EthicalEarth/Radio_SI4735_v1.0_stable/README.md

# Radio_SI4735_v1.0_stable
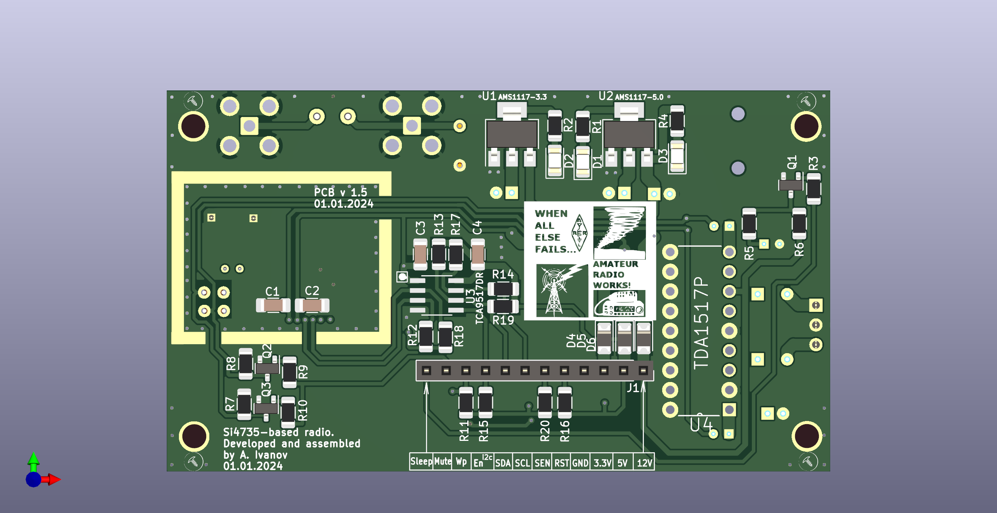
[picture p1: Gerber/SI4735t.png]
Top view

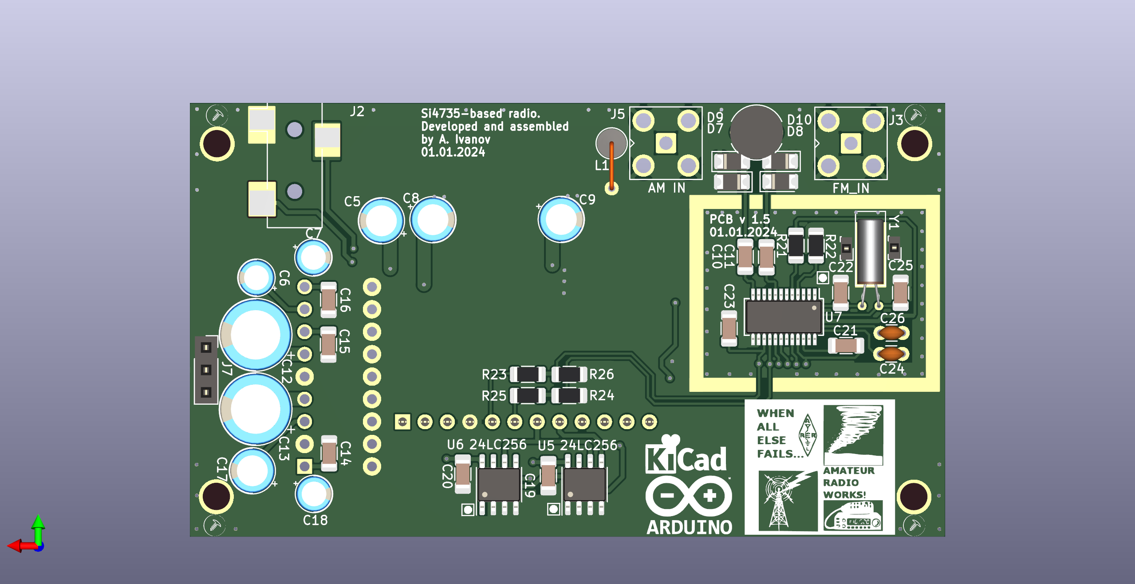
[picture p2: Gerber/SI4735b.png]
Bottom view
