EthicalEarth/Radio_SI4735_v1.0_stable/TCA9517DR/TCA9517DR.step

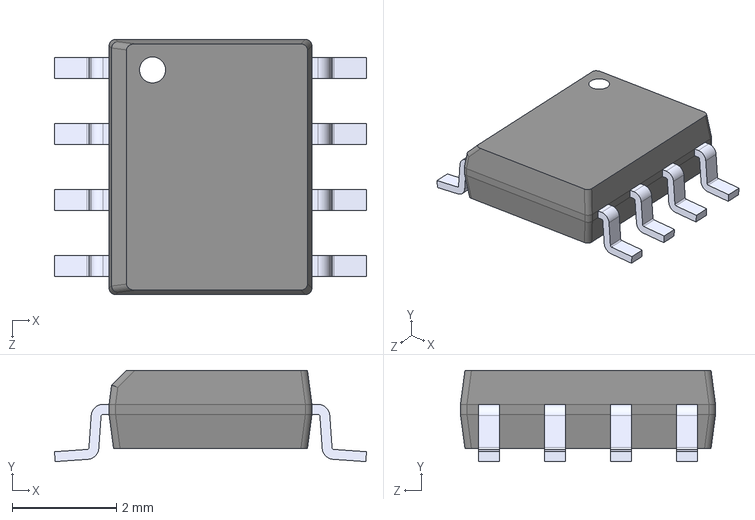
[picture p3: CAD file, 2024-03-23]
TCA9517DR/TCA9517DR.step
5.99 x 1.75 x 4.90 mm
