EthicalEarth/Radio_SI4735_v1.0_stable/TDA1517/TDA1517P_N3_112.step

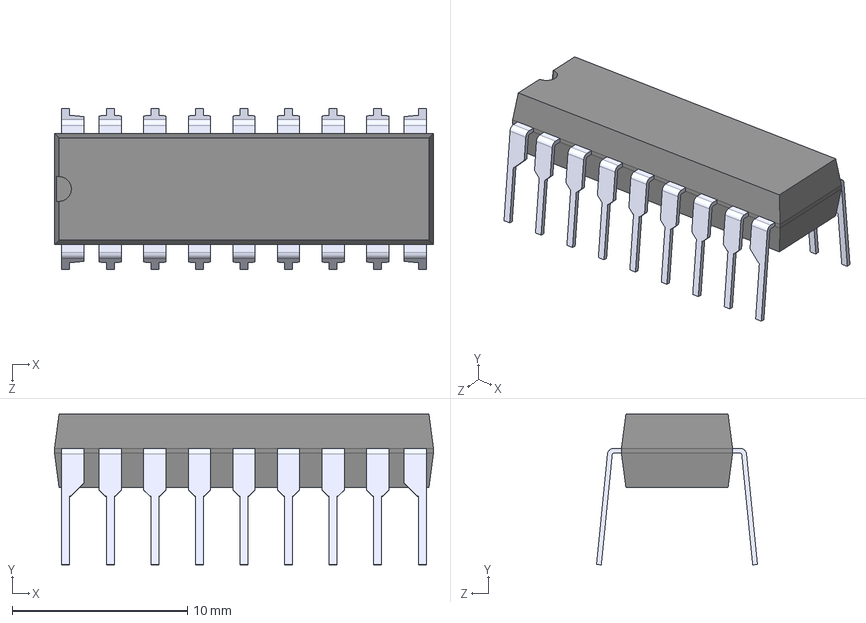
[picture p4: CAD file, 2024-03-23]
TDA1517/TDA1517P_N3_112.step
21.6 x 8.60 x 9.17 mm
