EthicalEarth/Radio_SI4735_v1.0_stable/SI4735.kicad_pcb

## KiCad design SI4735.kicad_pcb (2024-03-27)

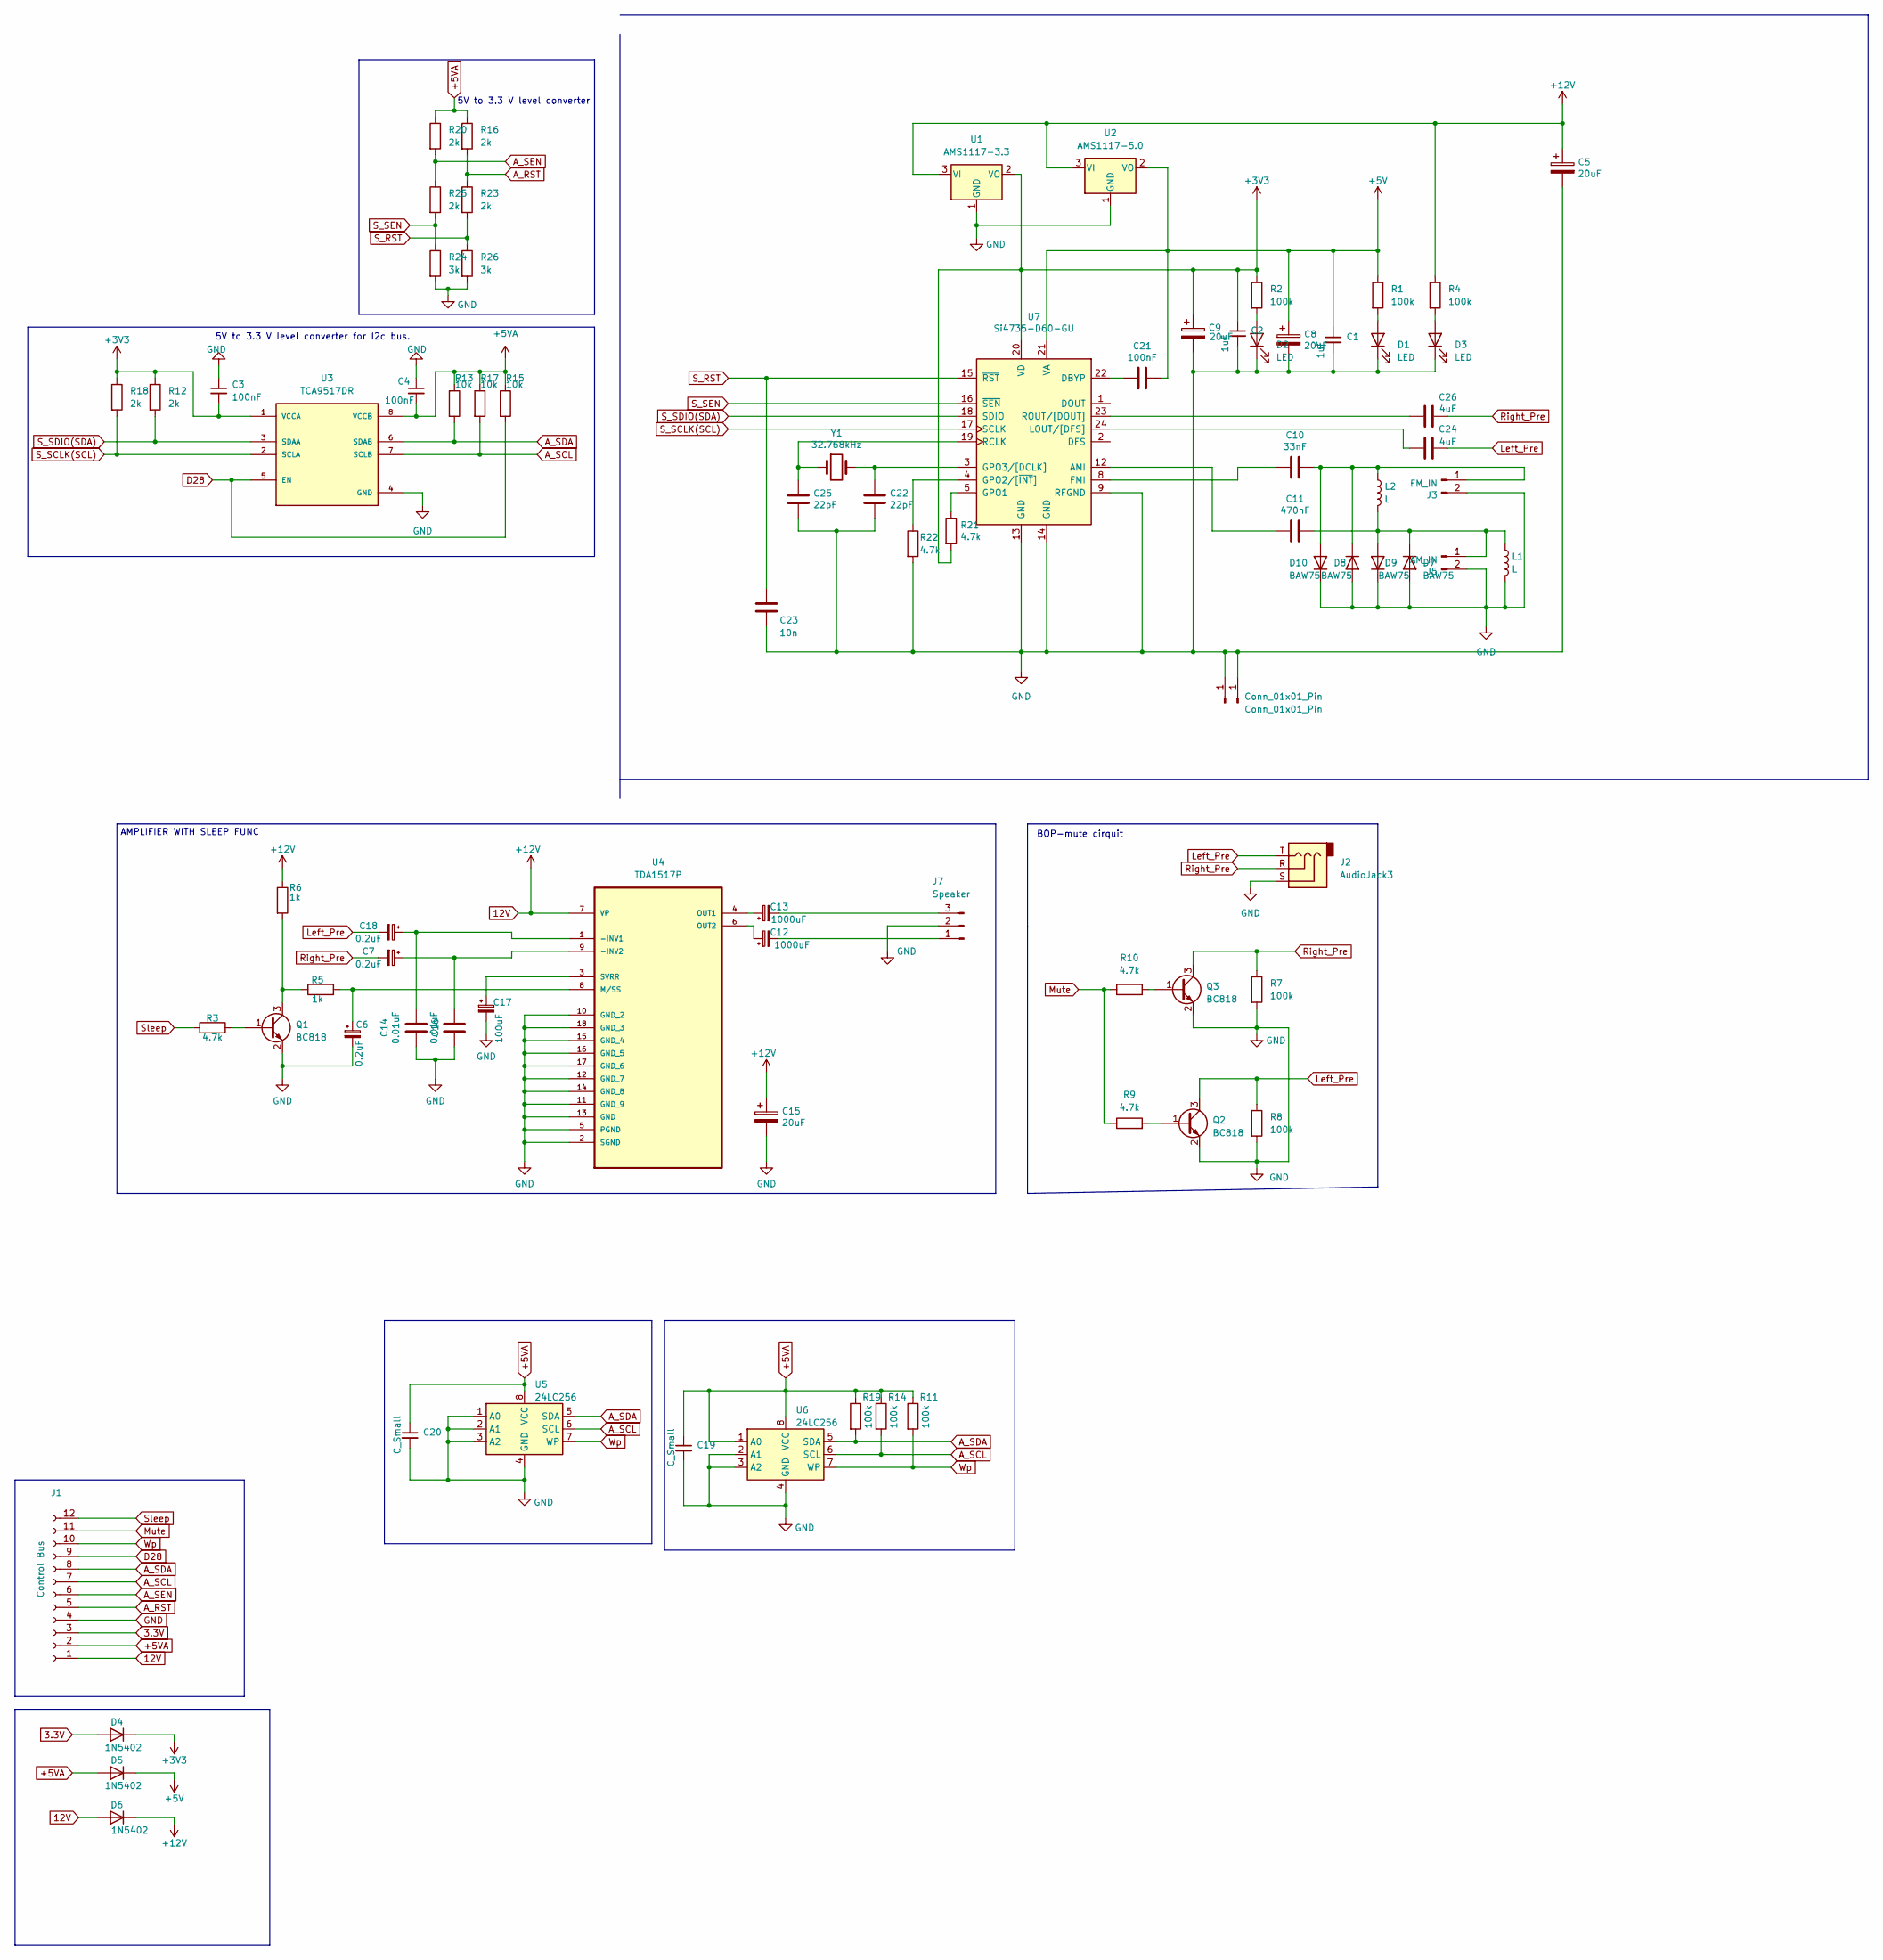
[picture p5: schematic SI4735.kicad_sch]

Parts:
C1, C2: 1uF; C_1206_3216Metric_Pad1.33x1.80mm_HandSolder
C3, C4, C21: 100nF; C_1206_3216Metric
C5, C8, C9: 20uF; CP_Radial_D5.0mm_P2.00mm
C6, C7, C18: 0.2uF; CP_Radial_D4.0mm_P2.00mm
C10: 33nF; C_1206_3216Metric
C11: 470nF; C_1206_3216Metric
C12, C13: 1000uF; CP_Radial_D8.0mm_P3.80mm
C14, C16: 0.01uF; C_1206_3216Metric
C15: 20uF; C_1206_3216Metric
C17: 100uF; CP_Radial_D5.0mm_P2.00mm
C19, C20: C_Small; C_1206_3216Metric_Pad1.33x1.80mm_HandSolder
C22, C25: 22pF; C_1206_3216Metric
C23: 10n; C_1206_3216Metric
C24, C26: 4uF; C_Disc_D3.0mm_W1.6mm_P2.50mm
D1, D2, D3: LED; LED_1206_3216Metric
D4, D5, D6: 1N5402; D_1206_3216Metric
D7, D8, D9, D10: BAW75; D_1206_3216Metric
J1: Control Bus; PinSocket_1x12_P2.54mm_Vertical
J2: AudioJack3; Jack_3.5mm_CUI_SJ-3523-SMT_Horizontal
J3: FM_IN; SMA_Amphenol_901-143_Horizontal
J4, J6: Conn_01x01_Pin; PinSocket_1x01_P1.27mm_Vertical
J5: AM_IN; SMA_Amphenol_901-143_Horizontal
J7: Speaker; PinSocket_1x03_P2.54mm_Vertical
L1: L; L_Axial_L7.0mm_D3.3mm_P5.08mm_Vertical_Fastron_MICC
L2: L; L_Radial_D6.0mm_P4.00mm
Q1, Q2, Q3: BC818; SOT-23
R1, R2, R4, R7, R8, R11, R14, R19: 100k; R_1206_3216Metric
R3, R9, R10, R21, R22: 4.7k; R_1206_3216Metric
R5, R6: 1k; R_1206_3216Metric
R12, R16, R18, R20, R23, R25: 2k; R_1206_3216Metric
R13, R15, R17: 10k; R_1206_3216Metric
R24, R26: 3k; R_1206_3216Metric
U1: AMS1117-3.3; SOT-223-3_TabPin2
U2: AMS1117-5.0; SOT-223-3_TabPin2
U3: TCA9517DR; SOIC127P599X175-8N; PARTREV D
U4: TDA1517P; DIP254P762X470-18; MPN TDA1517P/N3,112
U5, U6: 24LC256; SOIC-8_3.9x4.9mm_P1.27mm
U7: Si4735-D60-GU; SSOP-24_3.9x8.7mm_P0.635mm
Y1: 32.768kHz; Crystal_C38-LF_D3.0mm_L8.0mm_Horizontal

Connections:
3.3V: D4.2 (A), J1.3
12V: C5.1, C15.1, D6.1 (K), D6.2 (A), J1.1, R4.1, R6.1, U1.3 (VI), U2.3 (VI), U4.7 (VP)
+3V3: C2.1, C3.2, C9.1, D4.1 (K), R2.1, R12.1, R18.1, R21.2, U1.2 (VO), U3.1 (VCCA), U7.20 (VD)
+5V: C1.1, C8.1, C21.1, D5.1 (K), R1.1, U2.2 (VO), U7.21 (VA)
+5VA: C4.2, C19.1, C20.1, D5.2 (A), J1.2, R11.1, R13.1, R14.1, R15.1, R16.1, R17.1, R19.1, R20.1, U3.8 (VCCB), U5.8 (VCC), U6.1 (A0), U6.8 (VCC)
A_RST: J1.5, R16.2, R23.1
A_SCL: J1.7, R14.2, R17.2, U3.7 (SCLB), U5.6 (SCL), U6.6 (SCL)
A_SDA: J1.8, R13.2, R19.2, U3.6 (SDAB), U5.5 (SDA), U6.5 (SDA)
A_SEN: J1.6, R20.2, R25.1
D28: J1.9, R15.2, U3.5 (EN)
GND: C1.2, C2.2, C3.1, C4.1, C5.2, C6.2, C8.2, C9.2, C14.2, C15.2, C16.2, C17.2, C19.2, C20.2, C22.2, C23.2, C25.2, D1.1 (K), D2.1 (K), D3.1 (K), D7.2 (A), D8.2 (A), D9.1 (K), D10.1 (K), J1.4, J2.S, J3.2, J4.1, J5.2, J6.1, J7.2, L1.2, Q1.2 (E), Q2.2 (E), Q3.2 (E), R7.2, R8.2, R22.2, R24.2, R26.2, U1.1 (GND), U2.1 (GND), U3.4 (GND), U4.2 (SGND), U4.5 (PGND), U4.10 (GND_2), U4.11 (GND_9), U4.12 (GND_7), U4.13 (GND), U4.14 (GND_8), U4.15 (GND_4), U4.16 (GND_5), U4.17 (GND_6), U4.18 (GND_3), U5.1 (A0), U5.2 (A1), U5.3 (A2), U5.4 (GND), U6.2 (A1), U6.3 (A2), U6.4 (GND), U7.9 (RFGND), U7.13 (GND), U7.14 (GND)
Left_Pre: C18.2, C24.1, J2.T, Q2.3 (C), R8.1
Mute: J1.11, R9.1, R10.1
unnamed: D1.2 (A), R1.2
unnamed: D2.2 (A), R2.2
unnamed: D3.2 (A), R4.2
unnamed: C11.1, D7.1 (K), D9.2 (A), J5.1, L1.1, L2.2
unnamed: C10.1, D8.1 (K), D10.2 (A), J3.1, L2.1
unnamed: C12.2, J7.1
unnamed: C13.2, J7.3
unnamed: Q1.1 (B), R3.2
unnamed: Q1.3 (C), R5.1, R6.2
unnamed: Q2.1 (B), R9.2
unnamed: Q3.1 (B), R10.2
unnamed: C14.1, C18.1, U4.1 (-INV1)
unnamed: C7.1, C16.1, U4.9 (-INV2)
unnamed: C6.1, R5.2, U4.8 (M/SS)
unnamed: C13.1, U4.4 (OUT1)
unnamed: C12.1, U4.6 (OUT2)
unnamed: C17.1, U4.3 (SVRR)
unnamed: C11.2, U7.12 (AMI)
unnamed: C21.2, U7.22 (DBYP)
unnamed: C10.2, U7.8 (FMI)
unnamed: R21.1, U7.5 (GPO1)
unnamed: R22.1, U7.4 (GPO2/[~INT])
unnamed: C22.1, U7.3 (GPO3/[DCLK]), Y1.2
unnamed: C24.2, U7.24 (LOUT/[DFS])
unnamed: C25.1, U7.19 (RCLK), Y1.1
unnamed: C26.2, U7.23 (ROUT/[DOUT])
Right_Pre: C7.2, C26.1, J2.R, Q3.3 (C), R7.1
S_RST: C23.1, R23.2, R26.1, U7.15 (~RST)
S_SCLK(SCL): R18.2, U3.2 (SCLA), U7.17 (SCLK)
S_SDIO(SDA): R12.2, U3.3 (SDAA), U7.18 (SDIO)
S_SEN: R24.1, R25.2, U7.16 (~SEN)
Sleep: J1.12, R3.1
Wp: J1.10, R11.2, U5.7 (WP), U6.7 (WP)

Notes on the sheet:
5V to 3.3 V level converter for I2c bus.
5V to 3.3 V level converter
BOP-mute cirquit
AMPLIFIER WITH SLEEP FUNC

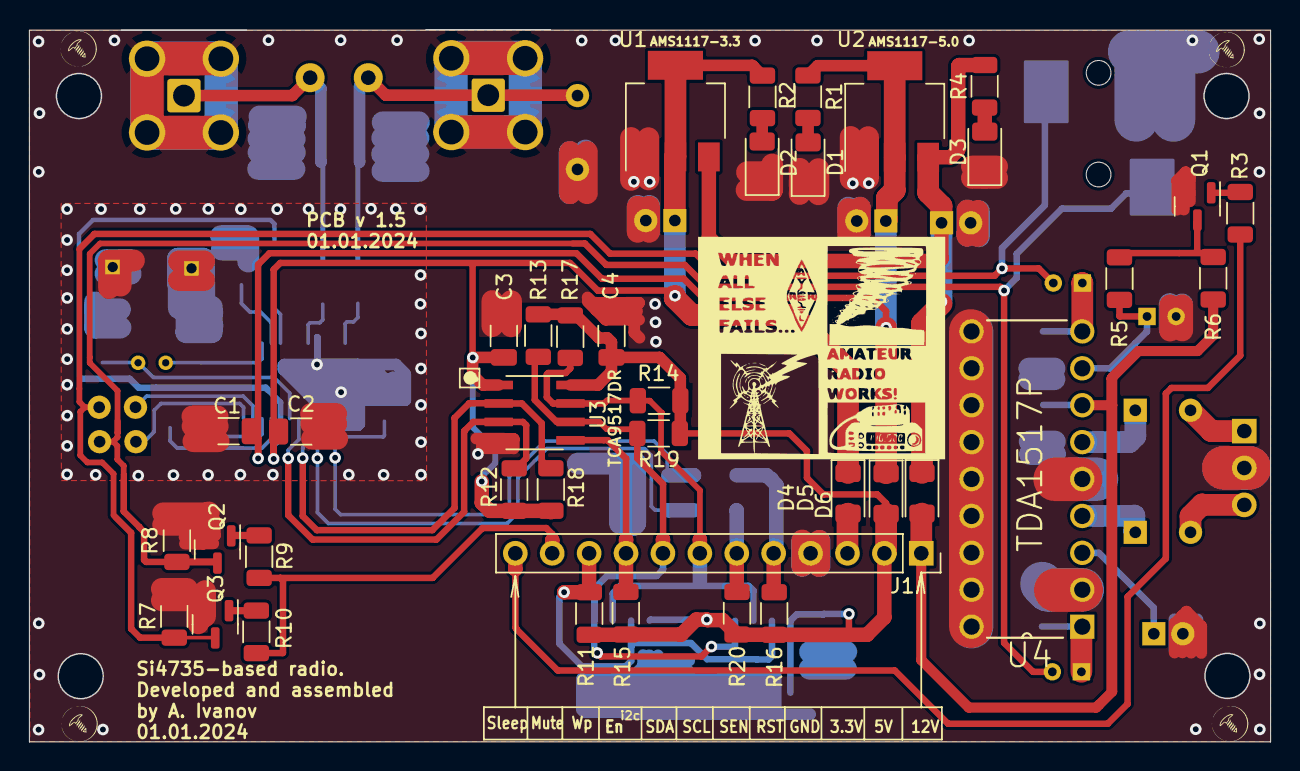
[picture p6: board SI4735.kicad_pcb from above]

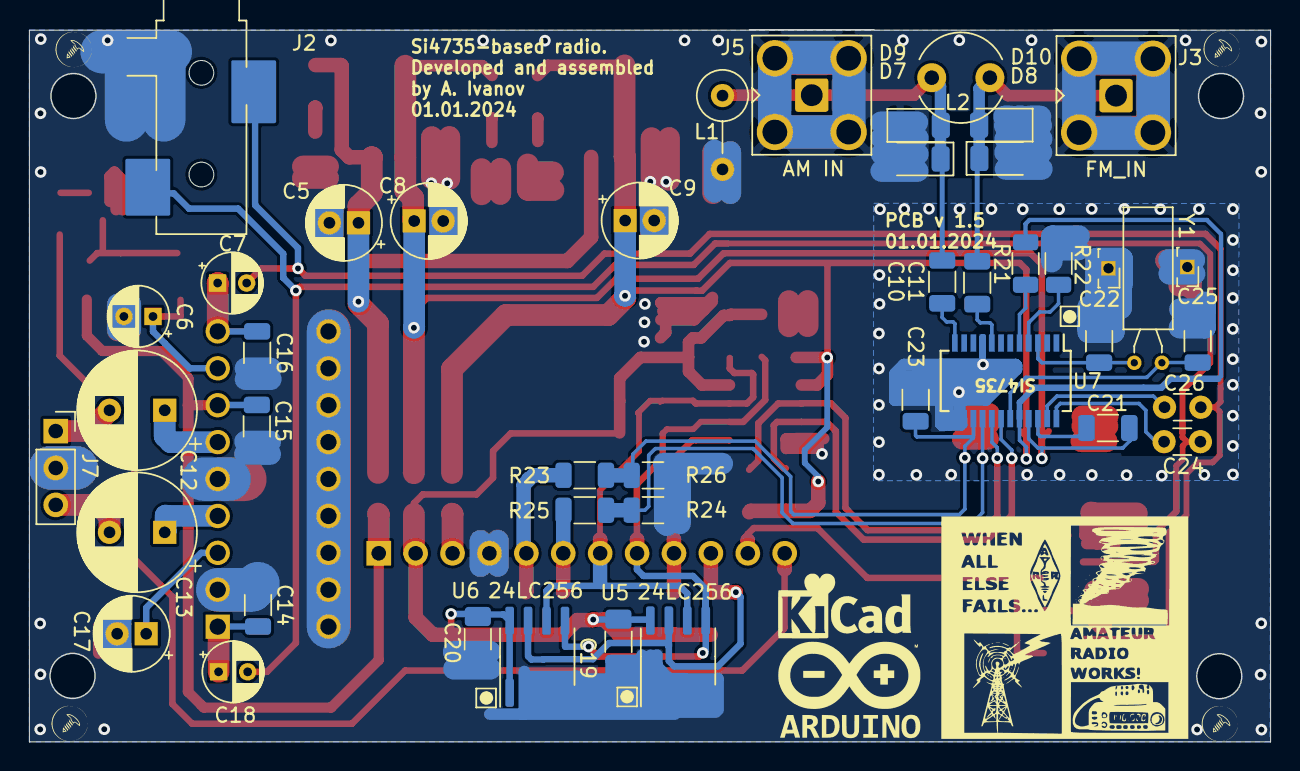
[picture p7: board SI4735.kicad_pcb from below]

Board: 2 copper layers, 85.4 x 49.0 mm, 82 parts (44 on the bottom side), 46 nets.
